cmmakerclub/Balancing-Robot/Solidwork_BB/Assem1.SLDASM

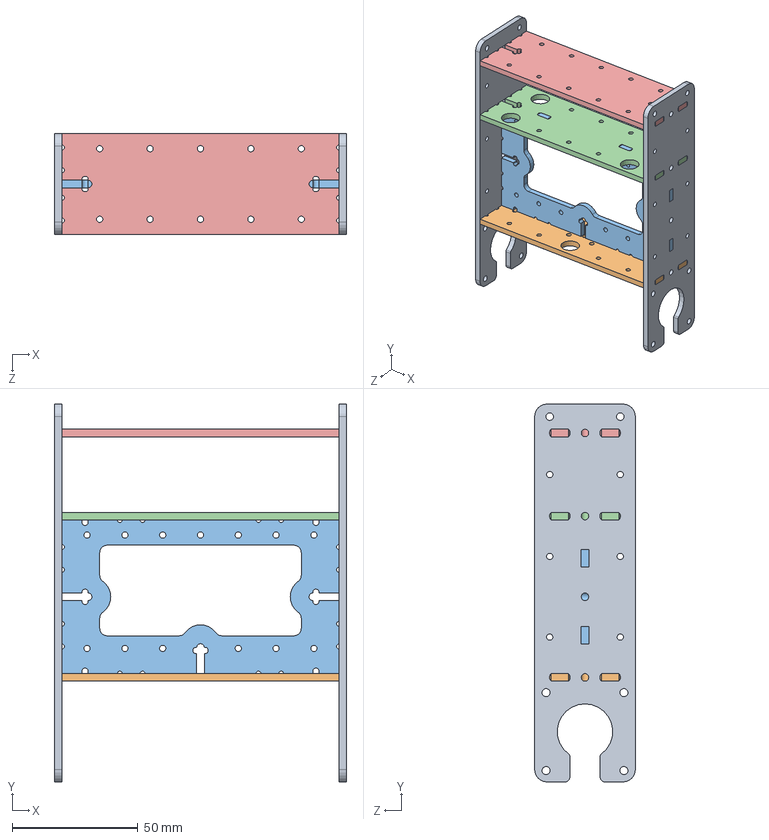
[picture p1: CAD file, 2014-12-29]
Solidwork_BB/Assem1.SLDASM
116.0 x 150.0 x 40.0 mm
ฝาด้านข้าง x 2
กลาง_1
กลาง_2
กลาง_3
กลาง_4
