cmmakerclub/Balancing-Robot/Solidwork_BB/ฝาด้านข้าง.SLDPRT

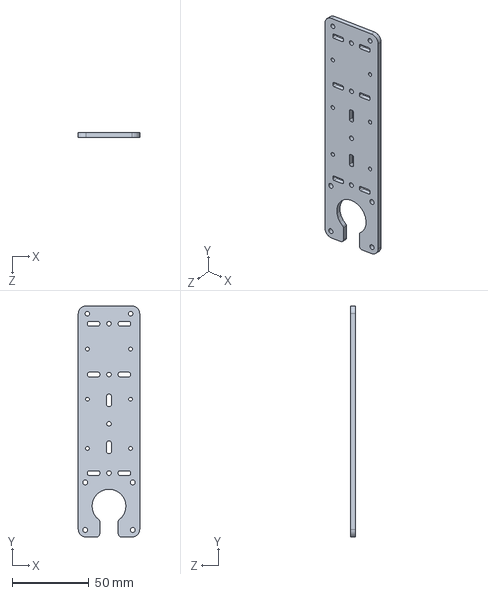
[picture p2: CAD file, 2014-12-29]
Solidwork_BB/ฝาด้านข้าง.SLDPRT
40.0 x 150.0 x 3.00 mm
