cmmakerclub/Balancing-Robot/Solidwork_BB/กลาง_3.SLDPRT

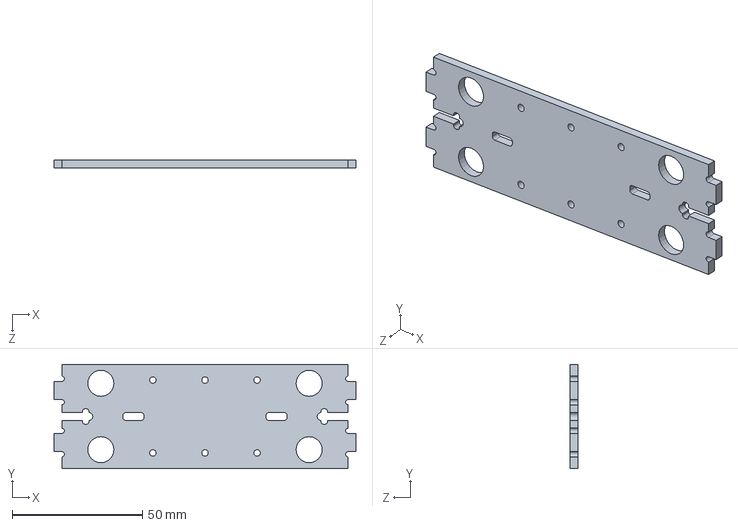
[picture p3: CAD file, 2014-12-29]
Solidwork_BB/กลาง_3.SLDPRT
116.0 x 40.0 x 3.00 mm
