cmmakerclub/Balancing-Robot/Solidwork_BB/กลาง_2.SLDPRT

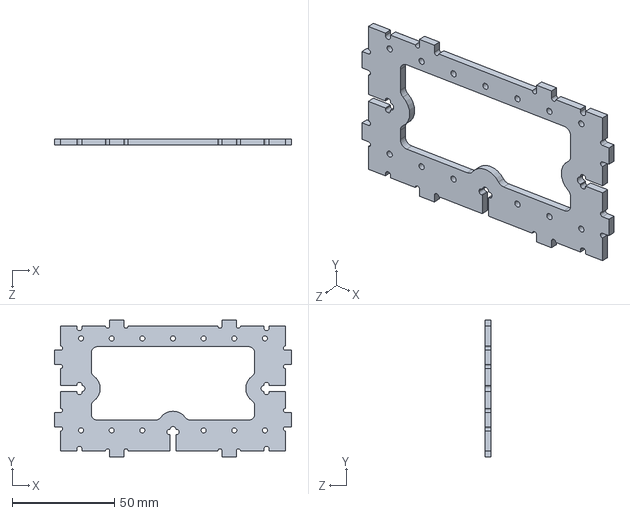
[picture p5: CAD file, 2014-12-29]
Solidwork_BB/กลาง_2.SLDPRT
116.0 x 67.0 x 3.00 mm
