cmmakerclub/Balancing-Robot/(list of files, cad)

Other CAD files:
Solidwork_BB/กลาง_4.SLDPRT
Solidwork_BB/กลาง_1.DWG
Solidwork_BB/กลาง_2.DWG
Solidwork_BB/กลาง_3.DWG
Solidwork_BB/กลาง_4.DWG
Solidwork_BB/ฝาด้านข้าง.DWG
