cmmakerclub/Balancing-Robot/Pcb G code/B Bot Cube.brd

## EAGLE design Pcb G code/B Bot Cube.brd (2014-12-31)

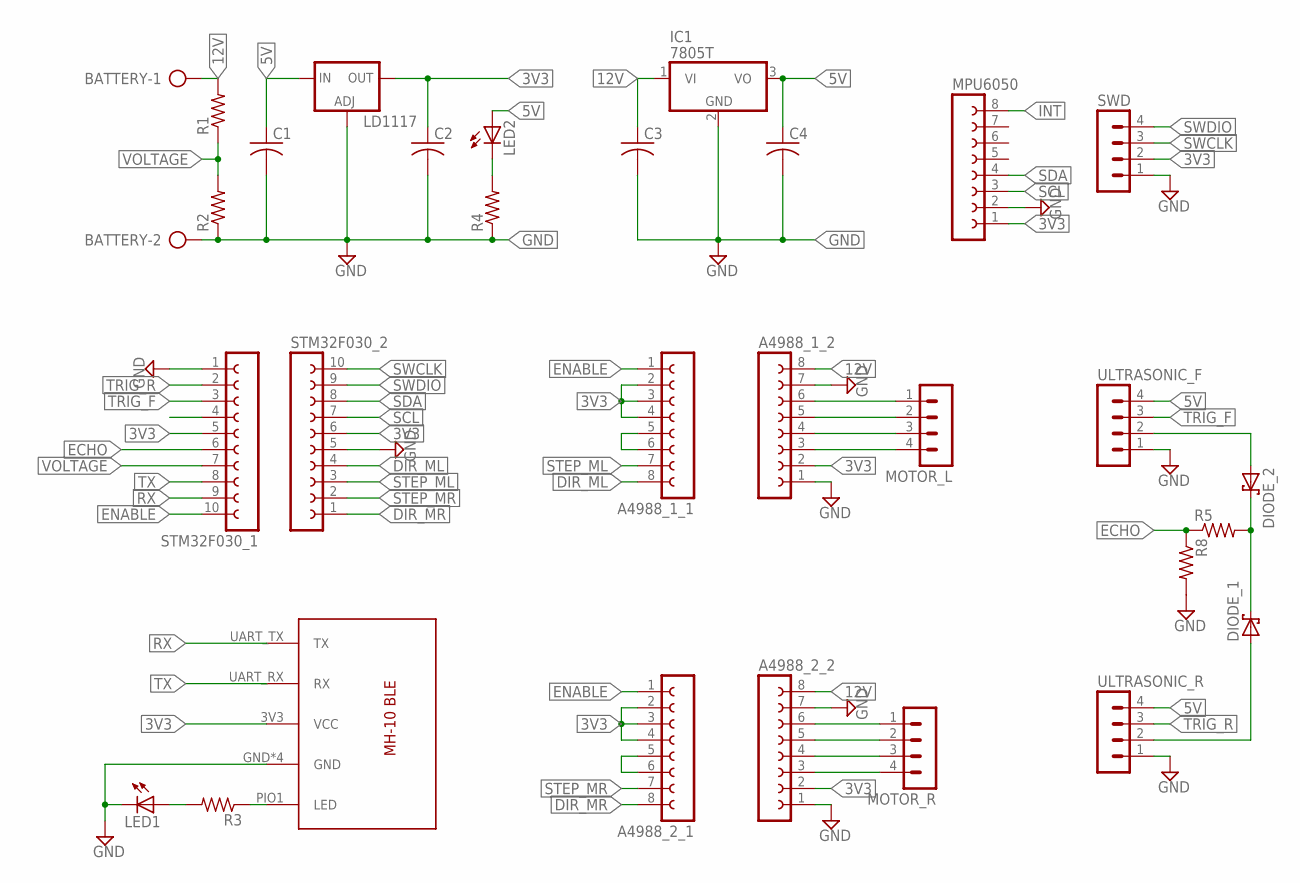
[picture p6: schematic B Bot Cube.sch]

Parts:
A4988_1_1, A4988_1_2, A4988_2_1, A4988_2_2: FE08-1; FE08
BATTERY: AK500/2
C1, C2, C3, C4: C-USC0805K; C0805K
DIODE_1, DIODE_2: BAT60J; SOD323_ST
IC1: 7805T; TO220H
LD1117: LD117AS33TR; SOT223
LED1, LED2: LED-0805; LED-805
MOTOR_L: MA04-1
MOTOR_R: MA04-1
MPU6050: FE08-1; FE08
R1, R2, R3, R4, R5, R8: R-US_M0805; M0805
STM32F030_1, STM32F030_2: FE10-1; FE10
SWD: MA04-1
U$1: HM-10
ULTRASONIC_F: MA04-1
ULTRASONIC_R: MA04-1

Connections:
3V3: A4988_1_1.2, A4988_1_1.3, A4988_1_1.4, A4988_1_2.2, A4988_2_1.2, A4988_2_1.3, A4988_2_1.4, A4988_2_2.2, C2.1, LD1117.4 (OUT), MPU6050.1, STM32F030_1.5, STM32F030_2.6, SWD.2, U$1.3V3 (VCC)
5V: C1.1, C4.1, IC1.3 (VO), LD1117.3 (IN), LED2.A, ULTRASONIC_F.4, ULTRASONIC_R.4
12V: A4988_1_2.8, A4988_2_2.8, BATTERY.1, C3.1, IC1.1 (VI), R1.2
DIR_ML: A4988_1_1.8, STM32F030_2.4
DIR_MR: A4988_2_1.8, STM32F030_2.1
ECHO: R5.1, R8.1, STM32F030_1.6
ENABLE: A4988_1_1.1, A4988_2_1.1, STM32F030_1.10
GND: A4988_1_2.1, A4988_1_2.7, A4988_2_2.1, A4988_2_2.7, BATTERY.2, C1.2, C2.2, C3.2, C4.2, IC1.2 (GND), LD1117.1 (ADJ), LED1.C, MPU6050.2, R2.1, R4.1, R8.2, STM32F030_1.1, STM32F030_2.5, SWD.1, U$1.GND, U$1.GND2 (GND), U$1.GND3 (GND), U$1.GND4 (GND), ULTRASONIC_F.1, ULTRASONIC_R.1
INT: MPU6050.8
unnamed: DIODE_1.A, ULTRASONIC_R.2
unnamed: DIODE_2.A, ULTRASONIC_F.2
unnamed: DIODE_1.C, DIODE_2.C, R5.2
unnamed: LED2.C, R4.2
unnamed: LED1.A, R3.2
unnamed: R3.1, U$1.PIO1 (LED)
unnamed: A4988_2_1.5, A4988_2_1.6
unnamed: A4988_2_2.6, MOTOR_R.1
unnamed: A4988_2_2.5, MOTOR_R.2
unnamed: A4988_2_2.4, MOTOR_R.3
unnamed: A4988_2_2.3, MOTOR_R.4
unnamed: A4988_1_2.6, MOTOR_L.1
unnamed: A4988_1_2.5, MOTOR_L.2
unnamed: A4988_1_2.4, MOTOR_L.3
unnamed: A4988_1_2.3, MOTOR_L.4
unnamed: A4988_1_1.5, A4988_1_1.6
RX: STM32F030_1.9, U$1.UART_TX (TX)
SCL: MPU6050.3, STM32F030_2.7
SDA: MPU6050.4, STM32F030_2.8
STEP_ML: A4988_1_1.7, STM32F030_2.3
STEP_MR: A4988_2_1.7, STM32F030_2.2
SWCLK: STM32F030_2.10, SWD.3
SWDIO: STM32F030_2.9, SWD.4
TRIG_F: STM32F030_1.3, ULTRASONIC_F.3
TRIG_R: STM32F030_1.2, ULTRASONIC_R.3
TX: STM32F030_1.8, U$1.UART_RX (RX)
VOLTAGE: R1.1, R2.2, STM32F030_1.7

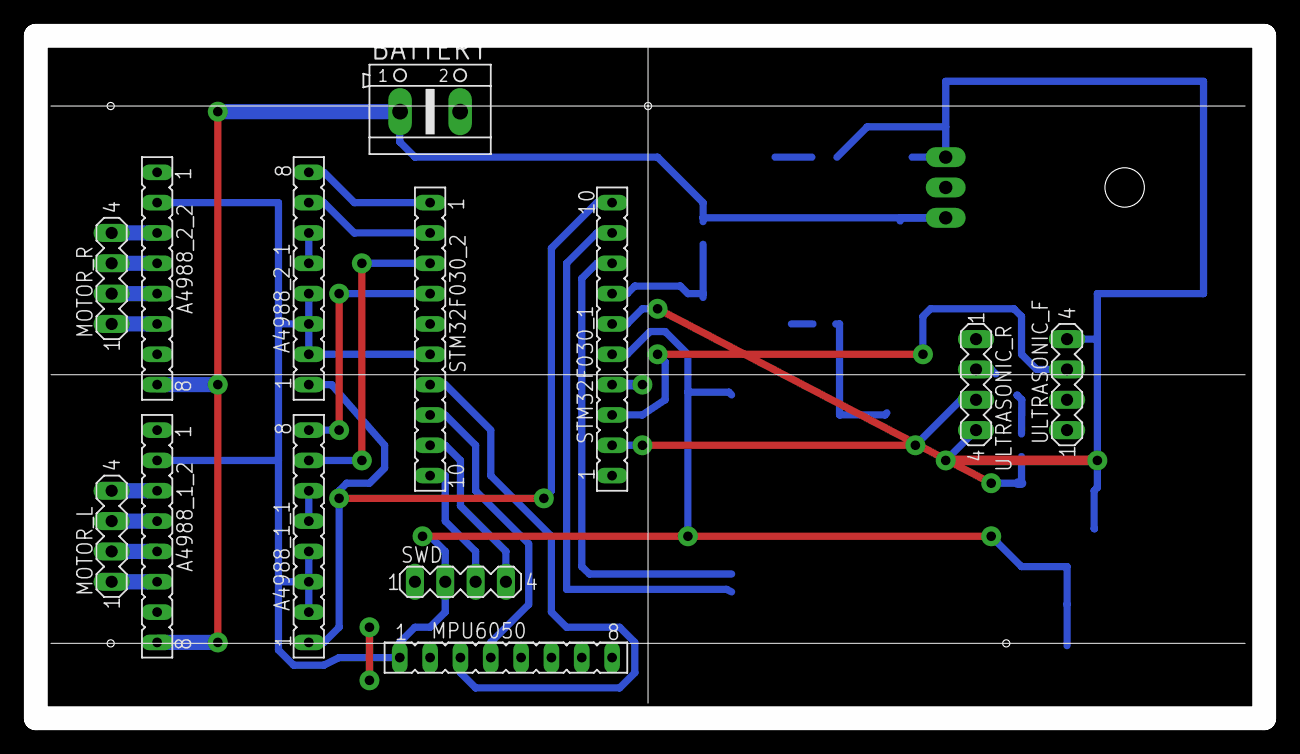
[picture p7: board B Bot Cube.brd from above]

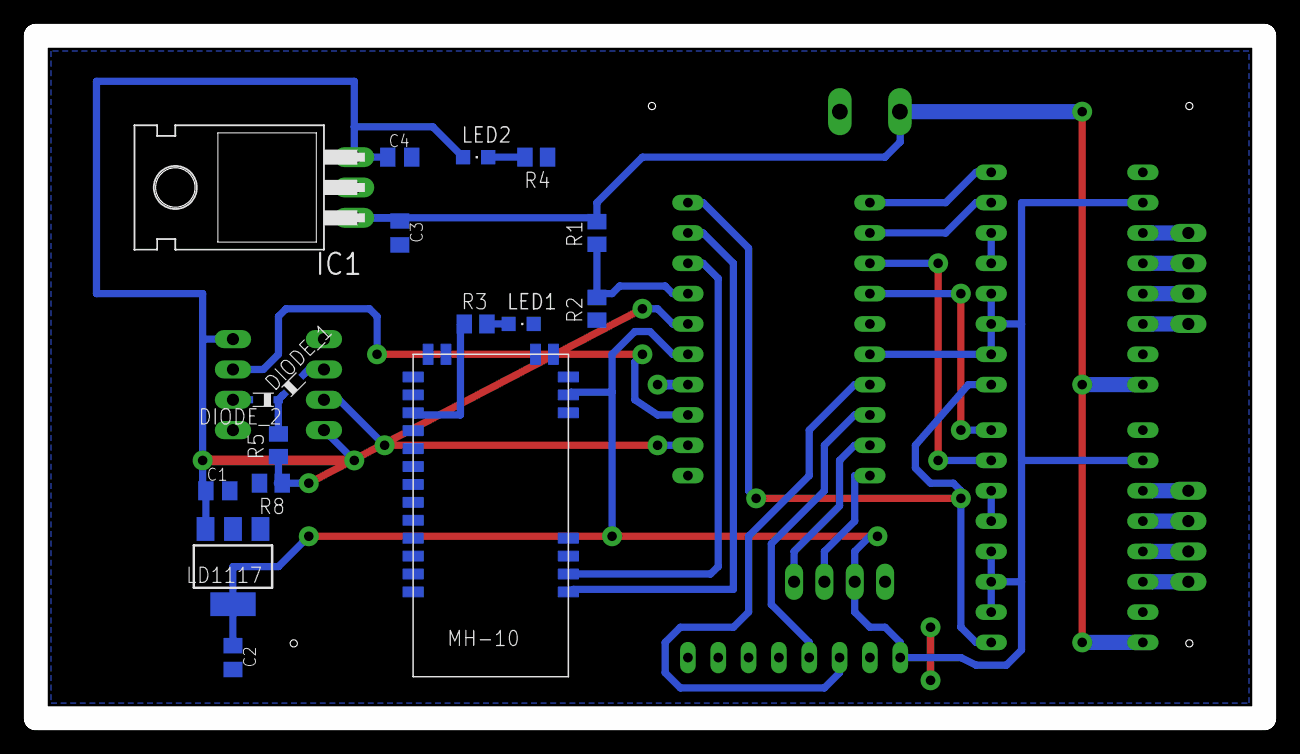
[picture p8: board B Bot Cube.brd from below]

Board: 2 copper layers, 102.9 x 57.2 mm, 30 parts (17 on the bottom side), 35 nets.
