cmmakerclub/Balancing-Robot/UV4/UV4.ioc

Mcu.UserName=STM32F030F4Px
PA0.GPIO_Label=Echo
PA0.Signal=GPXTI0
PA1.GPIO_Label=Voltage
PA1.Signal=ADC_IN1
PA10.Signal=I2C1_SDA
PA13.Signal=SYS_SWDIO
PA14.Signal=SYS_SWCLK
PA2.Signal=USART1_TX
PA3.Signal=USART1_RX
PA4.GPIO_Label=Enable_Motor
PA4.Signal=GPIO_Output
PA5.GPIO_Label=Dir_Motor_R
PA5.Signal=GPIO_Output
PA6.GPIO_Label=Step_Motor_R
PA6.Signal=S_TIM3_CH1
PA7.GPIO_Label=Step_motor_L
PA7.Signal=S_TIM14_CH1
PA9.Signal=I2C1_SCL
PB1.GPIO_Label=Dir_Motor_L
PB1.Signal=GPIO_Output
PF0-OSC_IN.GPIO_Label=Ultrasonic_F
PF0-OSC_IN.Signal=GPIO_Output
PF1-OSC_OUT.GPIO_Label=Ultrasonic_R
PF1-OSC_OUT.Signal=GPIO_Output
