cmmakerclub/Balancing-Robot/(commit log)

2014-12-29 add cad file
    [Assem1.SLDASM, กลาง_1.SLDPRT, กลาง_2.SLDPRT, กลาง_3.SLDPRT, กลาง_4.SLDPRT, ฝาด้านข้าง.SLDPRT]
2014-12-29 update and add dwg files
    [Assem1.SLDASM, กลาง_1.DWG, กลาง_1.SLDPRT, กลาง_2.DWG, กลาง_3.DWG, กลาง_3.SLDPRT, กลาง_4.DWG, ฝาด้านข้าง.DWG]
2014-12-29 fixed bug
    [ฝาด้านข้าง.DWG, ฝาด้านข้าง.SLDPRT]
2014-12-30 add pcb g code
2014-12-31 add eagle add mxcube
    [B Bot Cube.brd, B Bot Cube.sch]
2015-01-01 addsampling rate fixed Ahrs fixed i2c imp 10 uS
    [main.c]
2015-01-01 imp adc
2015-01-03 save before add dma
2015-01-03 add dma
2015-01-03 bug in control command >> velocity control over force to velocity control
    [UV4.ioc, main.c]
